eggsworks/chicklet/chicklet-v1/chicklet-v1-common.kicad_sch

## KiCad design chicklet-v1/chicklet-v1-common.kicad_sch (2023-11-24)

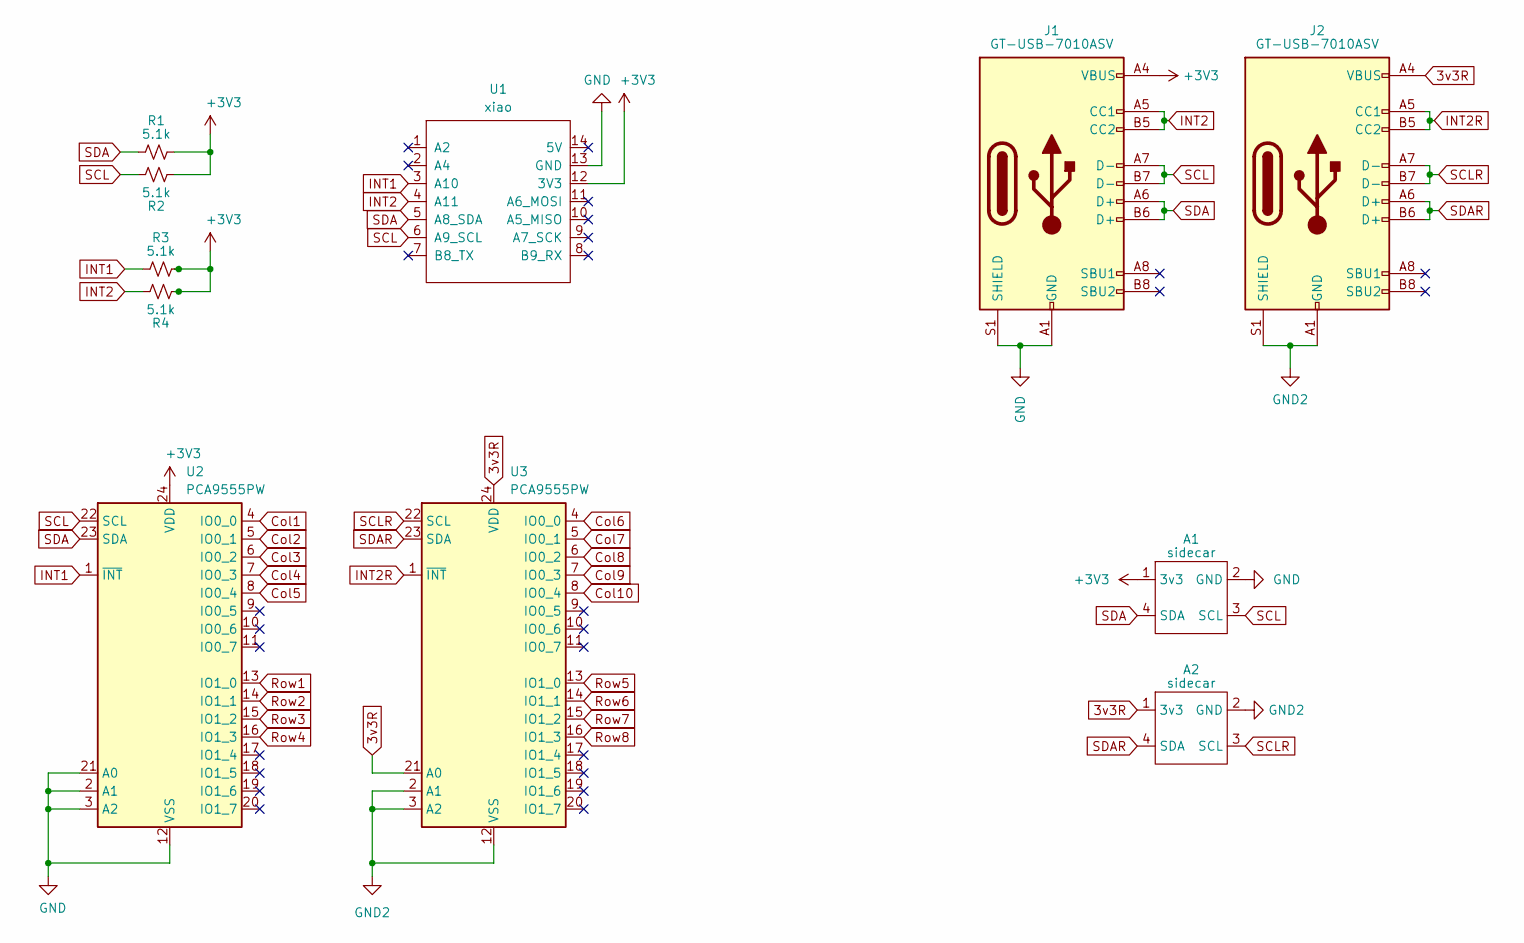
[picture p4: schematic chicklet-v1-common.kicad_sch]

Parts:
A1, A2: sidecar
J1, J2: GT-USB-7010ASV; USB_C_Receptacle_G-Switch_GT-USB-7010ASV
R1, R2, R3, R4: 5.1k; R_0603_1608Metric
U1: xiao; xiao-ble-smd-cutout
U2, U3: PCA9555PW; TSSOP-24_4.4x7.8mm_P0.65mm

Connections:
3v3R: A2.1 (3v3), J2.A4 (VBUS), J2.A9 (VBUS), J2.B4 (VBUS), J2.B9 (VBUS), U3.21 (A0), U3.24 (VDD)
+3V3: A1.1 (3v3), J1.A4 (VBUS), J1.A9 (VBUS), J1.B4 (VBUS), J1.B9 (VBUS), R1.2, R2.2, R3.2, R4.2, U1.12 (3V3), U2.24 (VDD)
Col1: U2.4 (IO0_0)
Col2: U2.5 (IO0_1)
Col3: U2.6 (IO0_2)
Col4: U2.7 (IO0_3)
Col5: U2.8 (IO0_4)
Col6: U3.4 (IO0_0)
Col7: U3.5 (IO0_1)
Col8: U3.6 (IO0_2)
Col9: U3.7 (IO0_3)
Col10: U3.8 (IO0_4)
GND: A1.2 (GND), J1.A1 (GND), J1.A12 (GND), J1.B1 (GND), J1.B12 (GND), J1.S1 (SHIELD), U1.13 (GND), U2.2 (A1), U2.3 (A2), U2.12 (VSS), U2.21 (A0)
GND2: A2.2 (GND), J2.A1 (GND), J2.A12 (GND), J2.B1 (GND), J2.B12 (GND), J2.S1 (SHIELD), U3.2 (A1), U3.3 (A2), U3.12 (VSS)
INT1: R3.1, U1.3 (A10), U2.1 (~INT)
INT2: J1.A5 (CC1), J1.B5 (CC2), R4.1, U1.4 (A11)
INT2R: J2.A5 (CC1), J2.B5 (CC2), U3.1 (~INT)
Row1: U2.13 (IO1_0)
Row2: U2.14 (IO1_1)
Row3: U2.15 (IO1_2)
Row4: U2.16 (IO1_3)
Row5: U3.13 (IO1_0)
Row6: U3.14 (IO1_1)
Row7: U3.15 (IO1_2)
Row8: U3.16 (IO1_3)
SCL: A1.3 (SCL), J1.A7 (D-), J1.B7 (D-), R2.1, U1.6 (A9_SCL), U2.22 (SCL)
SCLR: A2.3 (SCL), J2.A7 (D-), J2.B7 (D-), U3.22 (SCL)
SDA: A1.4 (SDA), J1.A6 (D+), J1.B6 (D+), R1.1, U1.5 (A8_SDA), U2.23 (SDA)
SDAR: A2.4 (SDA), J2.A6 (D+), J2.B6 (D+), U3.23 (SDA)
