eggsworks/chicklet/chicklet-v1/chicklet-v1-matrix.kicad_sch

## KiCad design chicklet-v1/chicklet-v1-matrix.kicad_sch (2023-11-24)

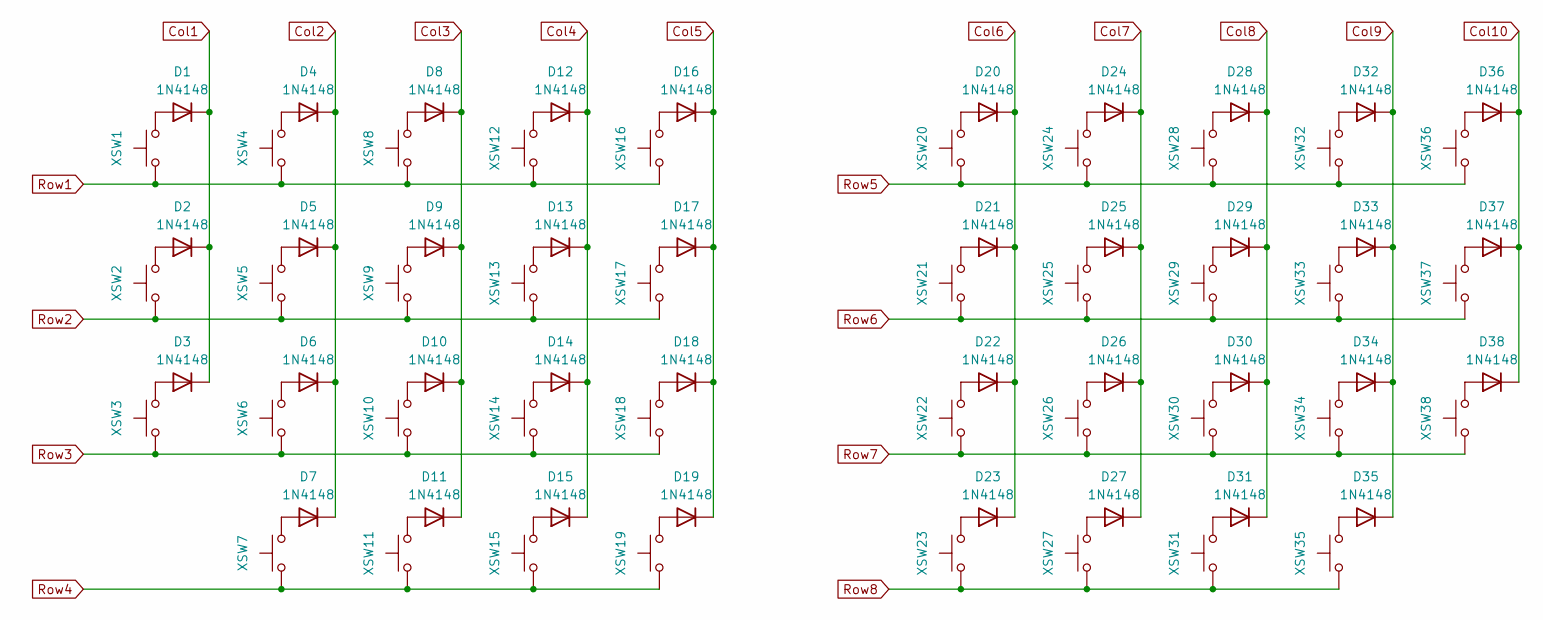
[picture p5: schematic chicklet-v1-matrix.kicad_sch]

Parts:
D1, D2, D3, D4, D5, D6, D7, D8, D9, D10, D11, D12, D13, D14, D15, D16, D17, D18, D19, D20, D21, D22, D23, D24, D25, D26, D27, D28, D29, D30, D31, D32, D33, D34, D35, D36, D37, D38: 1N4148; D_SOD-123
XSW1, XSW2, XSW3, XSW4, XSW5, XSW6, XSW7, XSW8, XSW9, XSW10, XSW11, XSW12, XSW13, XSW14, XSW15, XSW16, XSW17, XSW18, XSW19, XSW20, XSW21, XSW22, XSW23, XSW24, XSW25, XSW26, XSW27, XSW28, XSW29, XSW30, XSW31, XSW32, XSW33, XSW34, XSW35, XSW36, XSW37, XSW38: CPG135001S30

Connections:
Col1: D1.1 (K), D2.1 (K), D3.1 (K)
Col2: D4.1 (K), D5.1 (K), D6.1 (K), D7.1 (K)
Col3: D8.1 (K), D9.1 (K), D10.1 (K), D11.1 (K)
Col4: D12.1 (K), D13.1 (K), D14.1 (K), D15.1 (K)
Col5: D16.1 (K), D17.1 (K), D18.1 (K), D19.1 (K)
Col6: D20.1 (K), D21.1 (K), D22.1 (K), D23.1 (K)
Col7: D24.1 (K), D25.1 (K), D26.1 (K), D27.1 (K)
Col8: D28.1 (K), D29.1 (K), D30.1 (K), D31.1 (K)
Col9: D32.1 (K), D33.1 (K), D34.1 (K), D35.1 (K)
Col10: D36.1 (K), D37.1 (K), D38.1 (K)
unnamed: D1.2 (A), XSW1.2
unnamed: D2.2 (A), XSW2.2
unnamed: D3.2 (A), XSW3.2
unnamed: D4.2 (A), XSW4.2
unnamed: D5.2 (A), XSW5.2
unnamed: D6.2 (A), XSW6.2
unnamed: D7.2 (A), XSW7.2
unnamed: D8.2 (A), XSW8.2
unnamed: D9.2 (A), XSW9.2
unnamed: D10.2 (A), XSW10.2
unnamed: D11.2 (A), XSW11.2
unnamed: D12.2 (A), XSW12.2
unnamed: D13.2 (A), XSW13.2
unnamed: D14.2 (A), XSW14.2
unnamed: D15.2 (A), XSW15.2
unnamed: D16.2 (A), XSW16.2
unnamed: D17.2 (A), XSW17.2
unnamed: D18.2 (A), XSW18.2
unnamed: D19.2 (A), XSW19.2
unnamed: D20.2 (A), XSW20.2
unnamed: D21.2 (A), XSW21.2
unnamed: D22.2 (A), XSW22.2
unnamed: D23.2 (A), XSW23.2
unnamed: D24.2 (A), XSW24.2
unnamed: D25.2 (A), XSW25.2
unnamed: D26.2 (A), XSW26.2
unnamed: D27.2 (A), XSW27.2
unnamed: D28.2 (A), XSW28.2
unnamed: D29.2 (A), XSW29.2
unnamed: D30.2 (A), XSW30.2
unnamed: D31.2 (A), XSW31.2
unnamed: D32.2 (A), XSW32.2
unnamed: D33.2 (A), XSW33.2
unnamed: D34.2 (A), XSW34.2
unnamed: D35.2 (A), XSW35.2
unnamed: D36.2 (A), XSW36.2
unnamed: D37.2 (A), XSW37.2
unnamed: D38.2 (A), XSW38.2
Row1: XSW1.1, XSW4.1, XSW8.1, XSW12.1, XSW16.1
Row2: XSW2.1, XSW5.1, XSW9.1, XSW13.1, XSW17.1
Row3: XSW3.1, XSW6.1, XSW10.1, XSW14.1, XSW18.1
Row4: XSW7.1, XSW11.1, XSW15.1, XSW19.1
Row5: XSW20.1, XSW24.1, XSW28.1, XSW32.1, XSW36.1
Row6: XSW21.1, XSW25.1, XSW29.1, XSW33.1, XSW37.1
Row7: XSW22.1, XSW26.1, XSW30.1, XSW34.1, XSW38.1
Row8: XSW23.1, XSW27.1, XSW31.1, XSW35.1
