eggsworks/chicklet/chicklet-v1/chicklet-v1-misc.kicad_sch

## KiCad design chicklet-v1/chicklet-v1-misc.kicad_sch (2023-11-24)

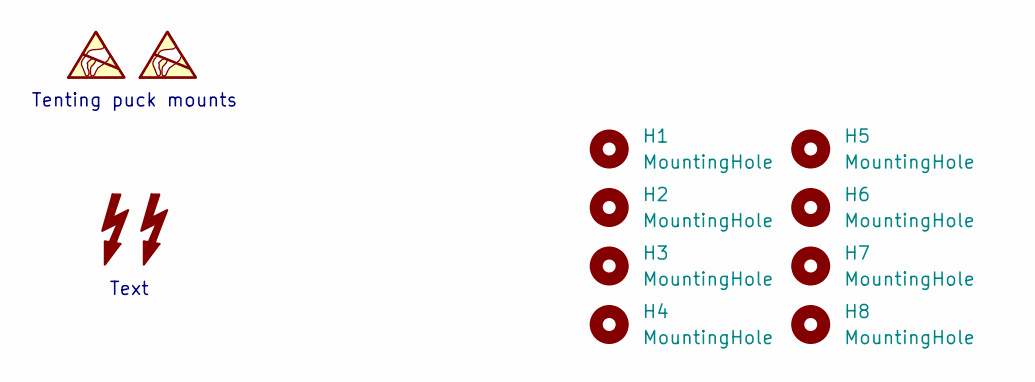
[picture p6: schematic chicklet-v1-misc.kicad_sch]

Parts:
H1, H2, H3, H4, H5, H6, H7, H8: MountingHole; MountingHole_2.2mm_M2

Notes on the sheet:
Text
Tenting puck mounts
